vthinh-la/Solar-Smart-IOT/docs/images/chart_current_vs_time.png

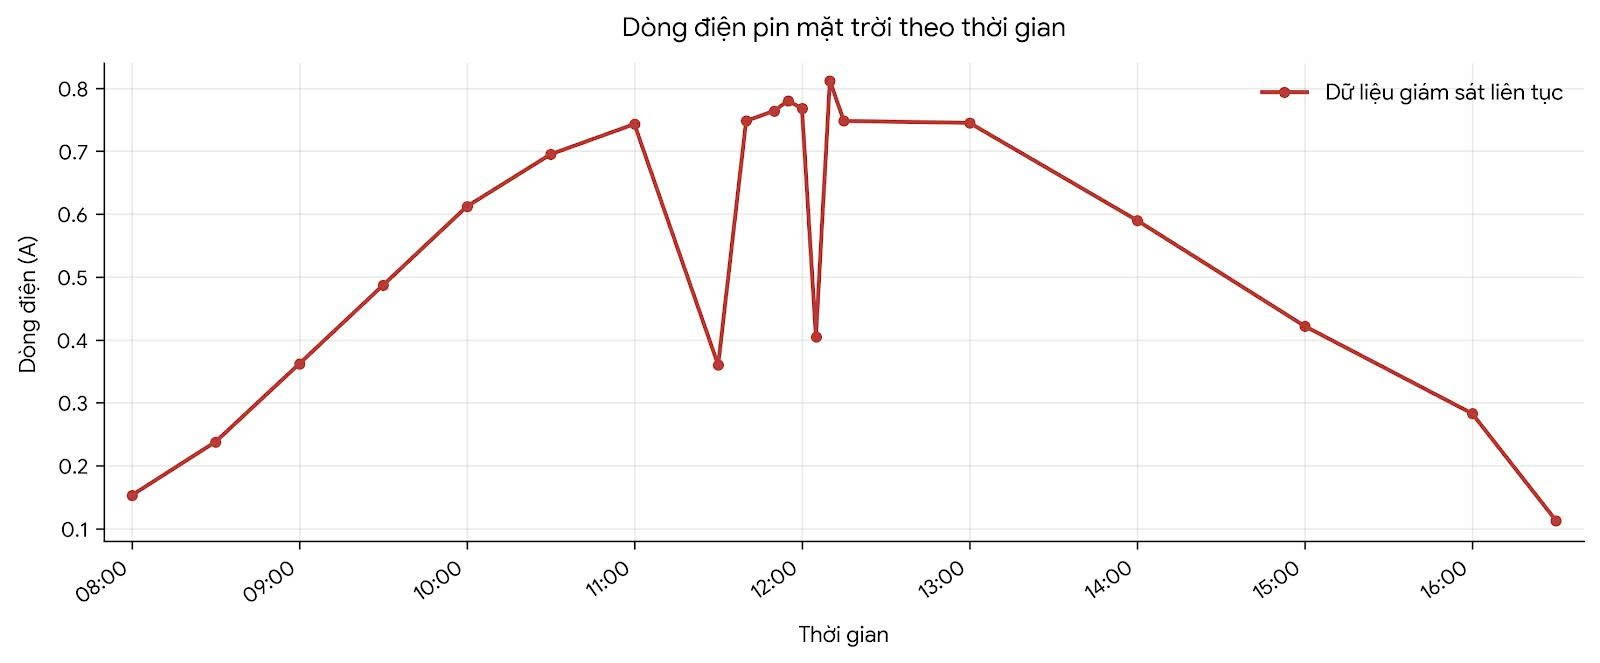
docs/images/chart_current_vs_time.png
