vthinh-la/Solar-Smart-IOT/docs/images/chart_power_vs_time.png

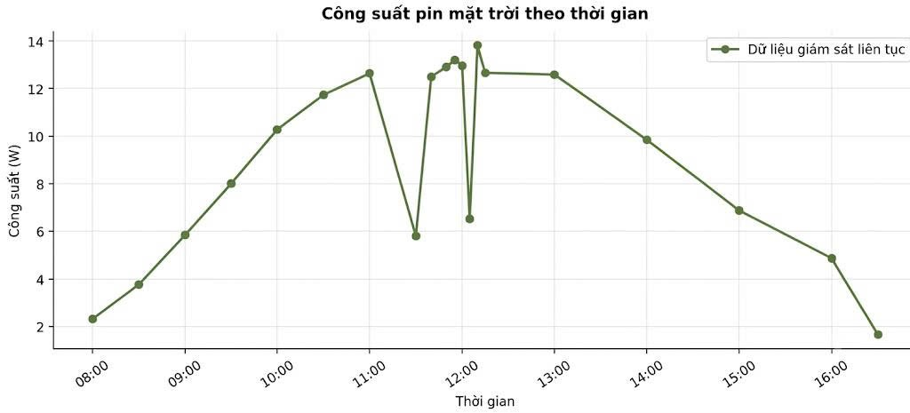
docs/images/chart_power_vs_time.png
