vthinh-la/Solar-Smart-IOT/docs/images/chart_voltage_vs_time.png

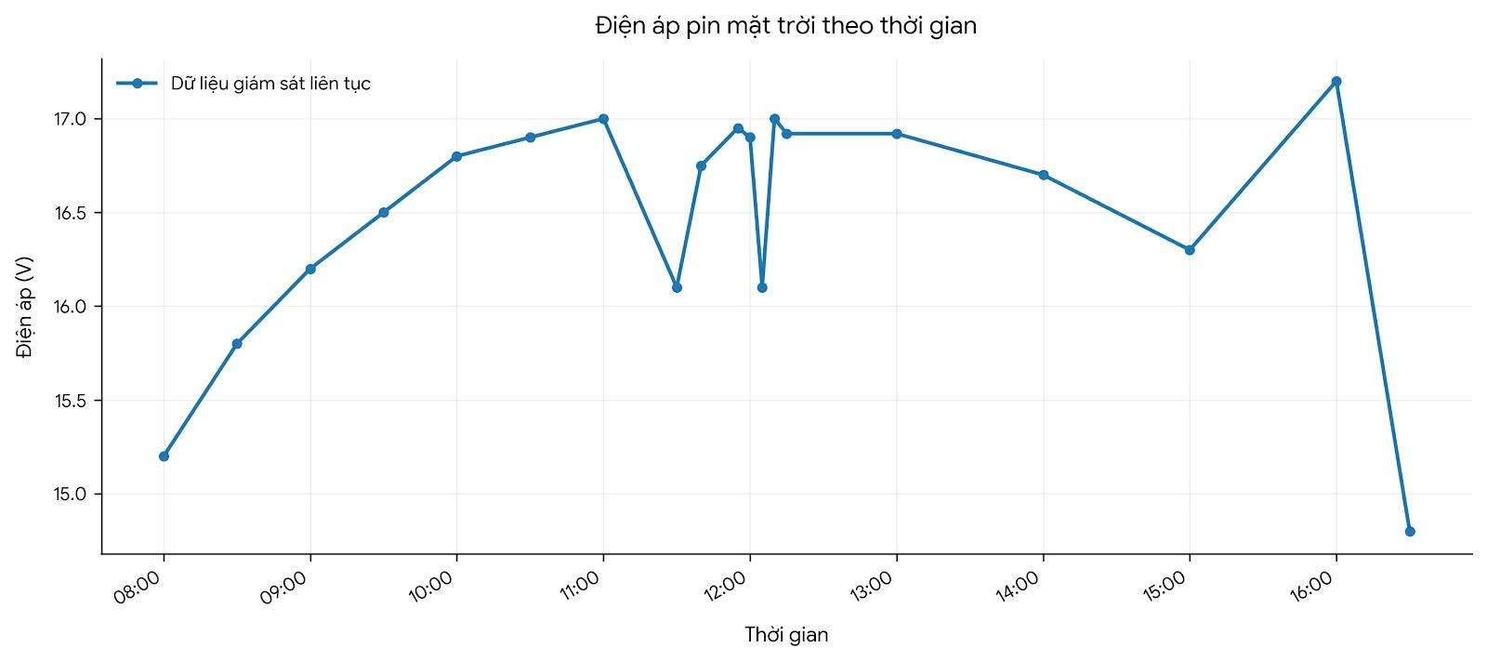
docs/images/chart_voltage_vs_time.png
