vthinh-la/Solar-Smart-IOT/docs/images/dashboard_desktop.png

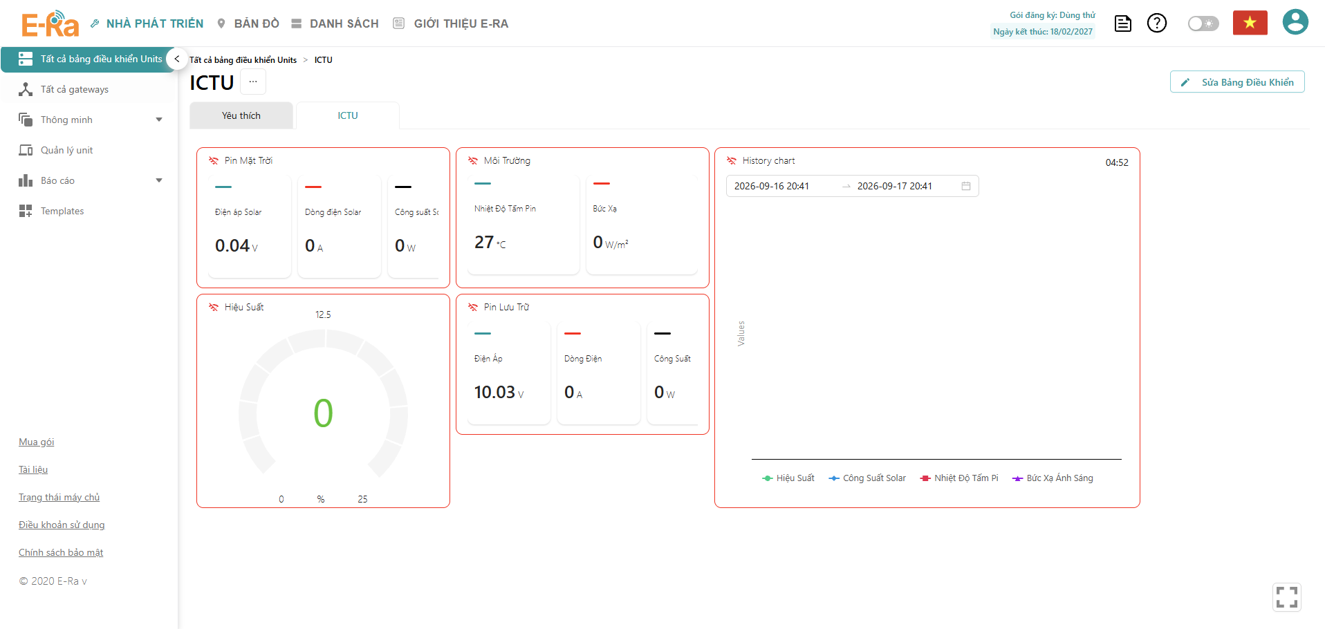
docs/images/dashboard_desktop.png
