vthinh-la/Solar-Smart-IOT/docs/images/flowchart_calculation.png

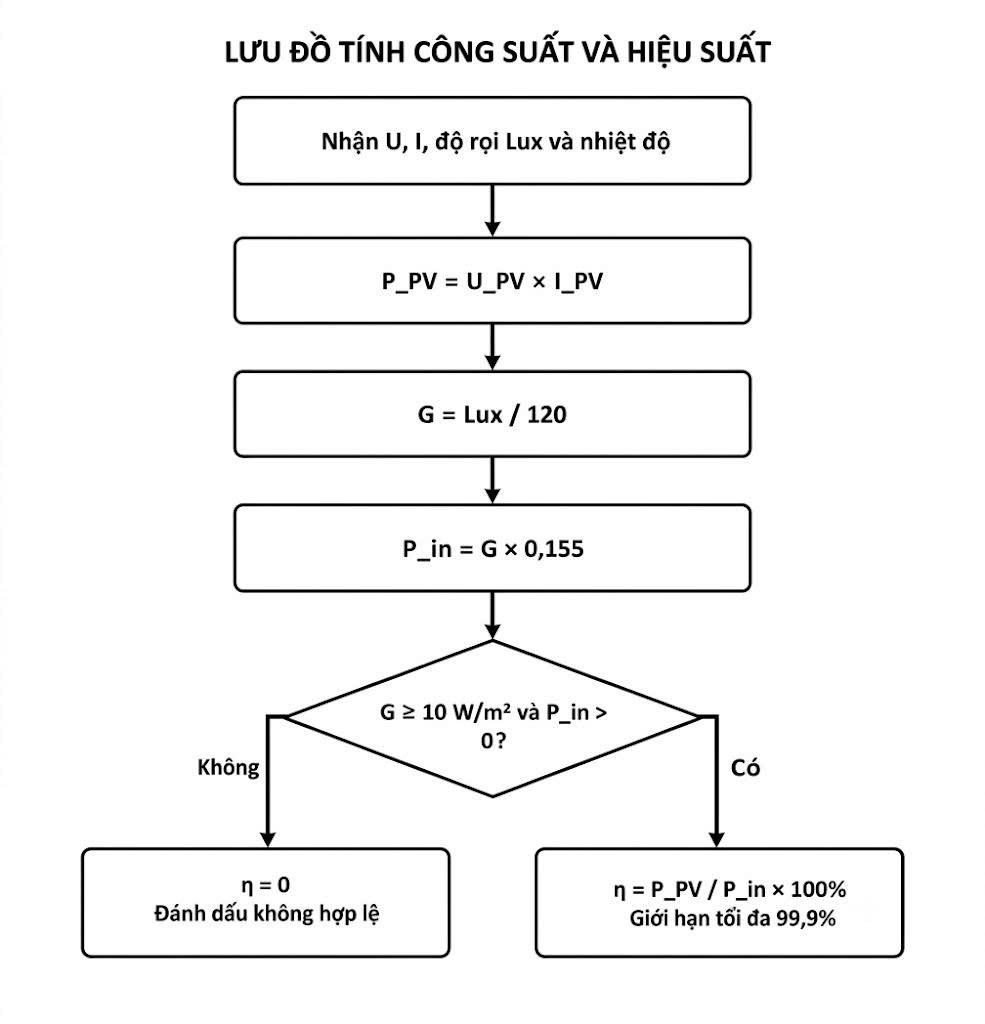
docs/images/flowchart_calculation.png
