vthinh-la/Solar-Smart-IOT/docs/images/flowchart_mqtt_sync.png

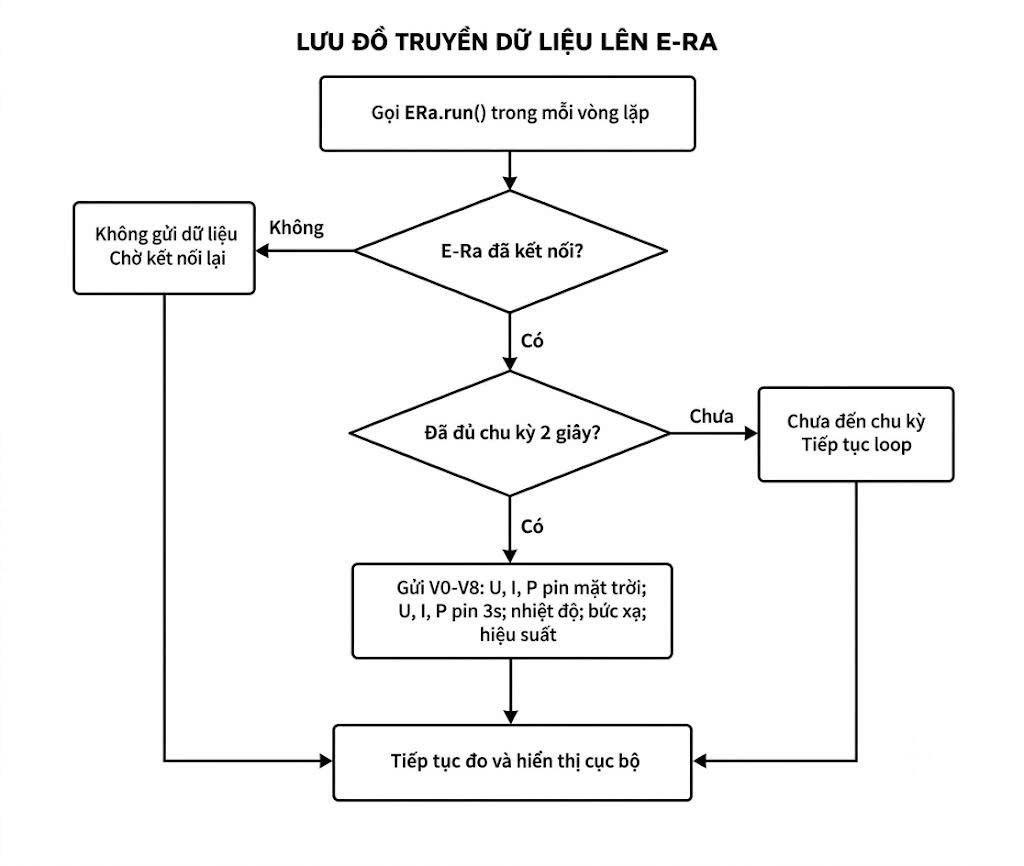
docs/images/flowchart_mqtt_sync.png
