vthinh-la/Solar-Smart-IOT/docs/images/flowchart_sensor_read.png

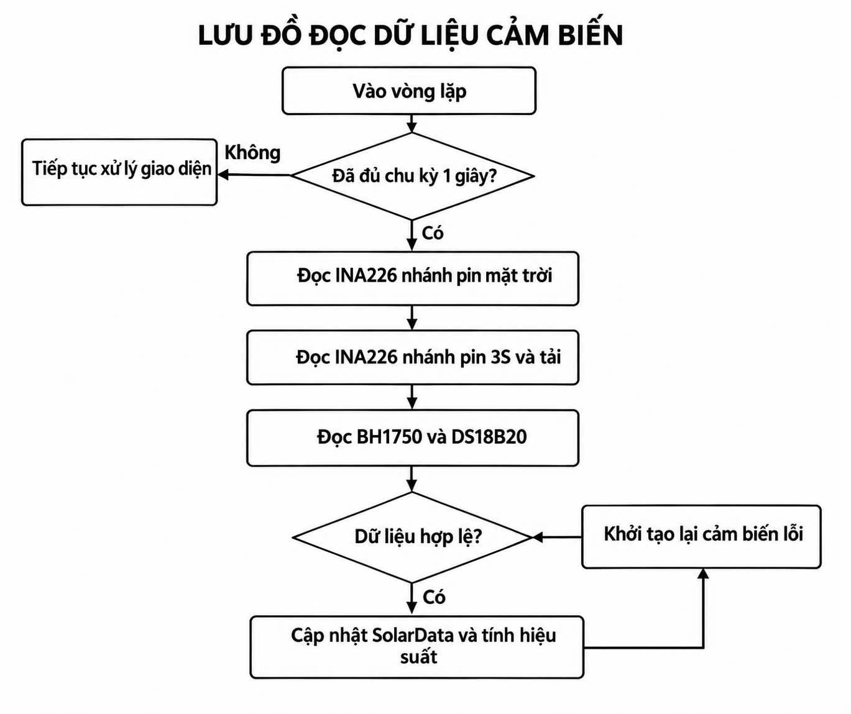
docs/images/flowchart_sensor_read.png
