vthinh-la/Solar-Smart-IOT/docs/images/flowchart_startup.png

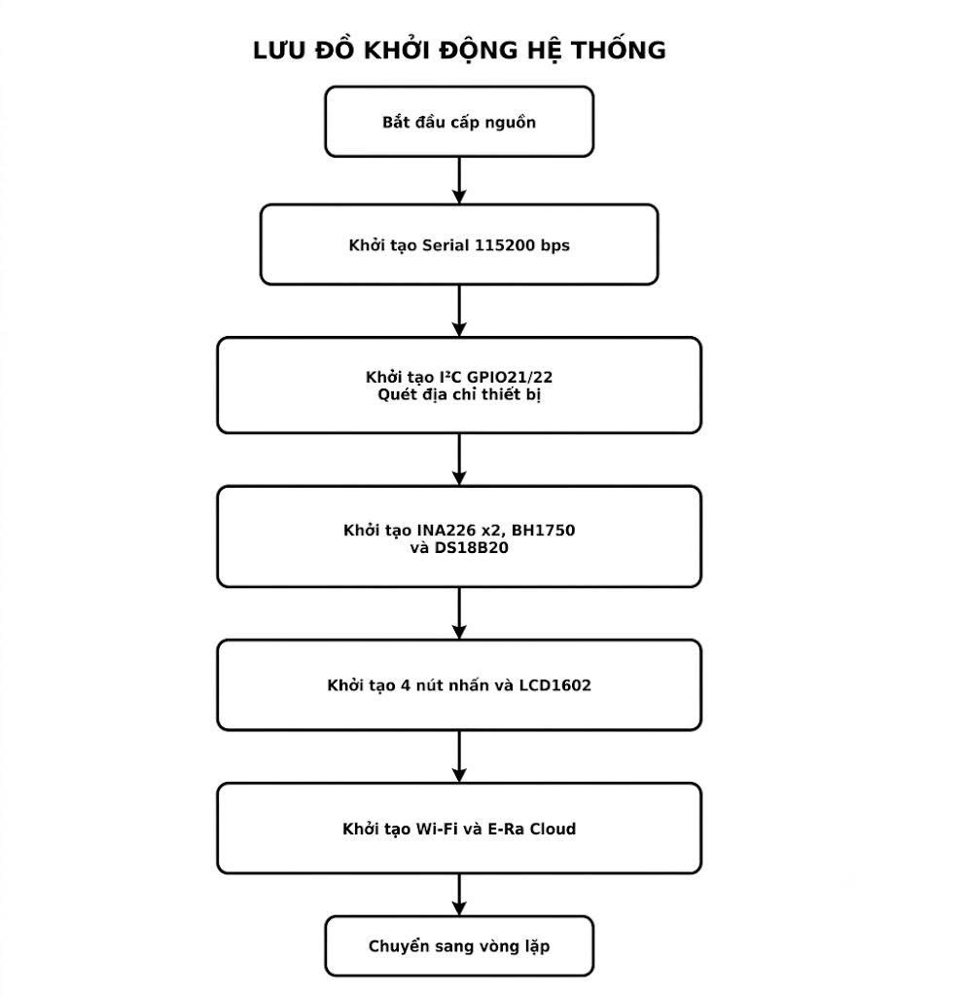
docs/images/flowchart_startup.png
