vthinh-la/Solar-Smart-IOT/hardware/mechanical/3d_models/Button_Cap_NUTz.stl

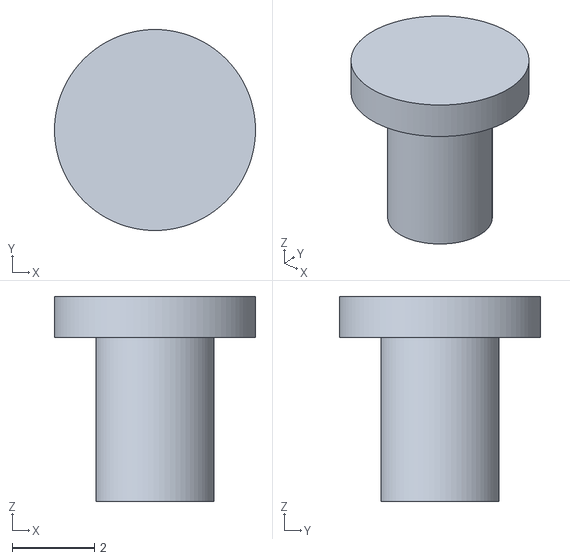
[picture p18: CAD file, 2026-10-18]
hardware/mechanical/3d_models/Button_Cap_NUTz.stl
4.90 x 4.90 x 5.00
