vthinh-la/Solar-Smart-IOT/hardware/mechanical/3d_models/Sensor_Housing.3mf

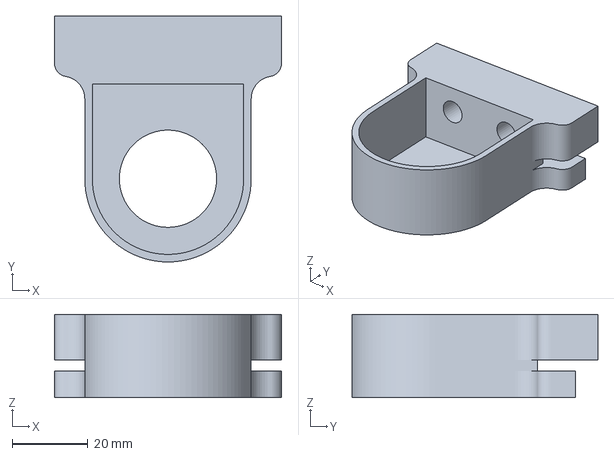
[picture p19: CAD file, 2026-10-18]
hardware/mechanical/3d_models/Sensor_Housing.3mf
60.0 x 65.0 x 22.0 mm
