vthinh-la/Solar-Smart-IOT/hardware/mechanical/3d_models/Base_Plate_De_Mach.3mf

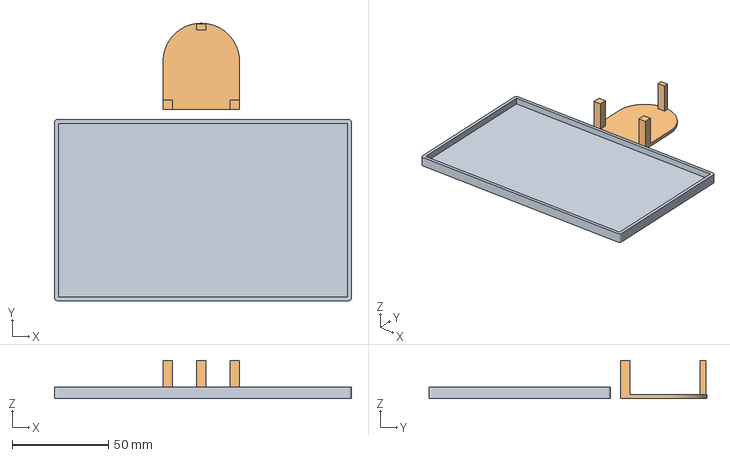
[picture p20: CAD file, 2026-10-18]
hardware/mechanical/3d_models/Base_Plate_De_Mach.3mf
154.3 x 144.2 x 19.8 mm
ĐẾ MẠCH.stl
NapCamBien.stl
