vthinh-la/Solar-Smart-IOT/hardware/mechanical/3d_models/LCD_Standoff_Pillars.stl

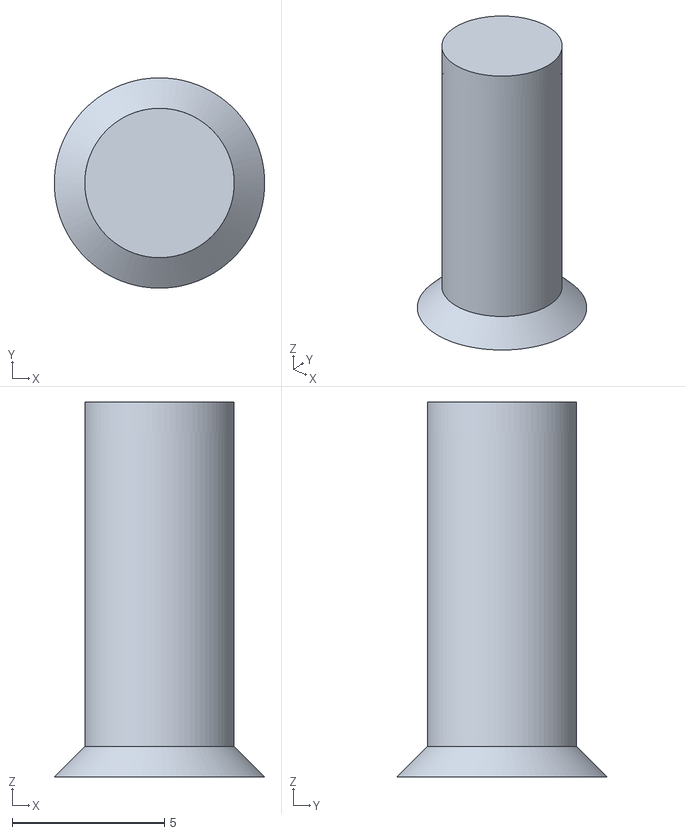
[picture p21: CAD file, 2026-10-18]
hardware/mechanical/3d_models/LCD_Standoff_Pillars.stl
6.90 x 6.90 x 12.3
