vthinh-la/Solar-Smart-IOT/hardware/mechanical/3d_models/Sensor_Lid.stl

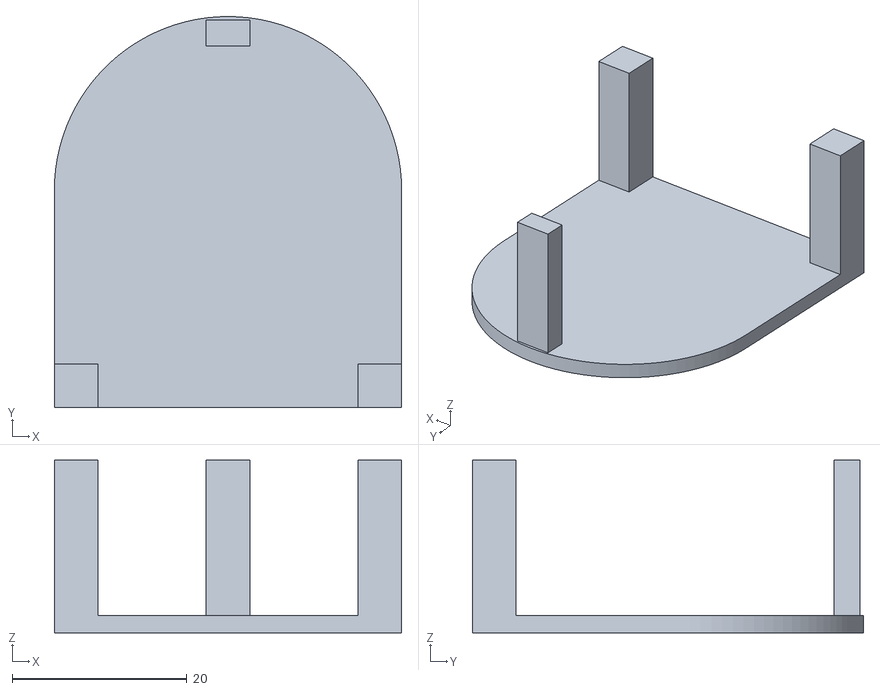
[picture p22: CAD file, 2026-10-18]
hardware/mechanical/3d_models/Sensor_Lid.stl
39.8 x 44.8 x 19.8
