vthinh-la/Solar-Smart-IOT/(list of files, cad)

Other CAD files:
hardware/mechanical/3d_models/Base_Plate_De_Mach.stl
hardware/mechanical/3d_models/Sensor_Housing.stl
hardware/mechanical/cad_source/Sensor_Housing_Parametric.f3d
