vthinh-la/Solar-Smart-IOT/(commit log)

2026-10-18 Initial commit with E-Ra IFrame widget and Smart Solar firmware
    [era_partition.csv, era_partition_16MB.csv, era_partition_8MB.csv]
2026-10-18 docs: add comprehensive hardware, architecture, assembly, testing and user documentation
    - Add detailed README.md with live telemetry results, hardware photos and system overview
    - Add MIT License
    - Add docs/ (architecture, bom, wiring, assembly, testing, known-issues, user-guide)
    - Add hardware/schematics/ (wiring schematic, block diagram, pinout reference)
    - Add hardware/mechanical/ (3D printable STL/3MF models, parametric CAD source .f3d, specifications)
    - Add 16 high-resolution field photos, diagrams and test charts to docs/images/
    [Base_Plate_De_Mach.3mf, Base_Plate_De_Mach.stl, Button_Cap_NUTz.stl, LCD_Standoff_Pillars.stl, Sensor_Housing.3mf, Sensor_Housing.stl, Sensor_Housing_Parametric.f3d, Sensor_Lid.stl]
2026-10-18 feat(firmware): optimize FreeRTOS dual-core tasking, sanitize credentials and update configs
    - Pin ERa MQTT telemetry task to Core 0 with asynchronous FreeRTOS queue
    - Keep high-speed sensor sampling and LCD1602 UI on Core 1 to prevent freezing
    - Sanitize WiFi credentials and E-Ra token with placeholder template config.example.h
    - Enhance .gitignore to protect secrets and local build artifacts
    [config.example.h, config.h, main.cpp]
2026-10-18 docs: add real-world demo video clips and animated GIF to README
    - Add docs/images/solar_iot_demo.gif showing real-time board operation under sunlight
    - Add media/solar_iot_hardware_live_test.mp4 demonstrating button navigation & live power measurement
    - Add media/solar_iot_cloud_and_shading_test.mp4 demonstrating environmental sensor pod & real-time E-Ra app sync
