vthinh-la/Solar-Smart-IOT/(notices)

Notices in the files:
README.md:
License: MIT
